CatoLynx/GIRA-Blinds-ESP8266-HW/BOM.xlsx

Item | Reference(s) | Order No. | Value | Supplier | Qty
1 | C1 | 593D226X9035D2TE3 | 22u | TME | 1
2 | C2 | VJ0603Y103KXAPW1BC | 10n | TME | 1
3 | C3,C7,C6 | CL21B105KOFNNNG | 1u | TME | 3
4 | C4 | 293D107X9010D2TE3 | 100u | TME | 1
5 | C5 | VJ0603Y104KXACW1BC | 100n | TME | 1
6 | D1 | SK110-DIO | SK110 | TME | 1
8 | L1 | B82432T1104K | 100u | TME | 1
9 | P1 |  | Interface | TME | 1
10 | Q1,Q2 | BC817-16-DIO | BC817 | TME | 2
11 | R5,R6,R1,R2 | RC0603FR-0710K | 10k | TME | 4
12 | R4,R3 | RC0603FR-074K7 | 4.7k | TME | 2
17 | U1 |  | ESP-12F | eBay | 1
18 | U2 | LM2674M-3.3/NOP | LM2674M-3.3 | TME | 1
