CatoLynx/GIRA-Blinds-ESP8266-HW/GIRA ESP8266 Jalousiesteuerung.kicad_pcb

## KiCad design GIRA ESP8266 Jalousiesteuerung.kicad_pcb (2018-10-30)

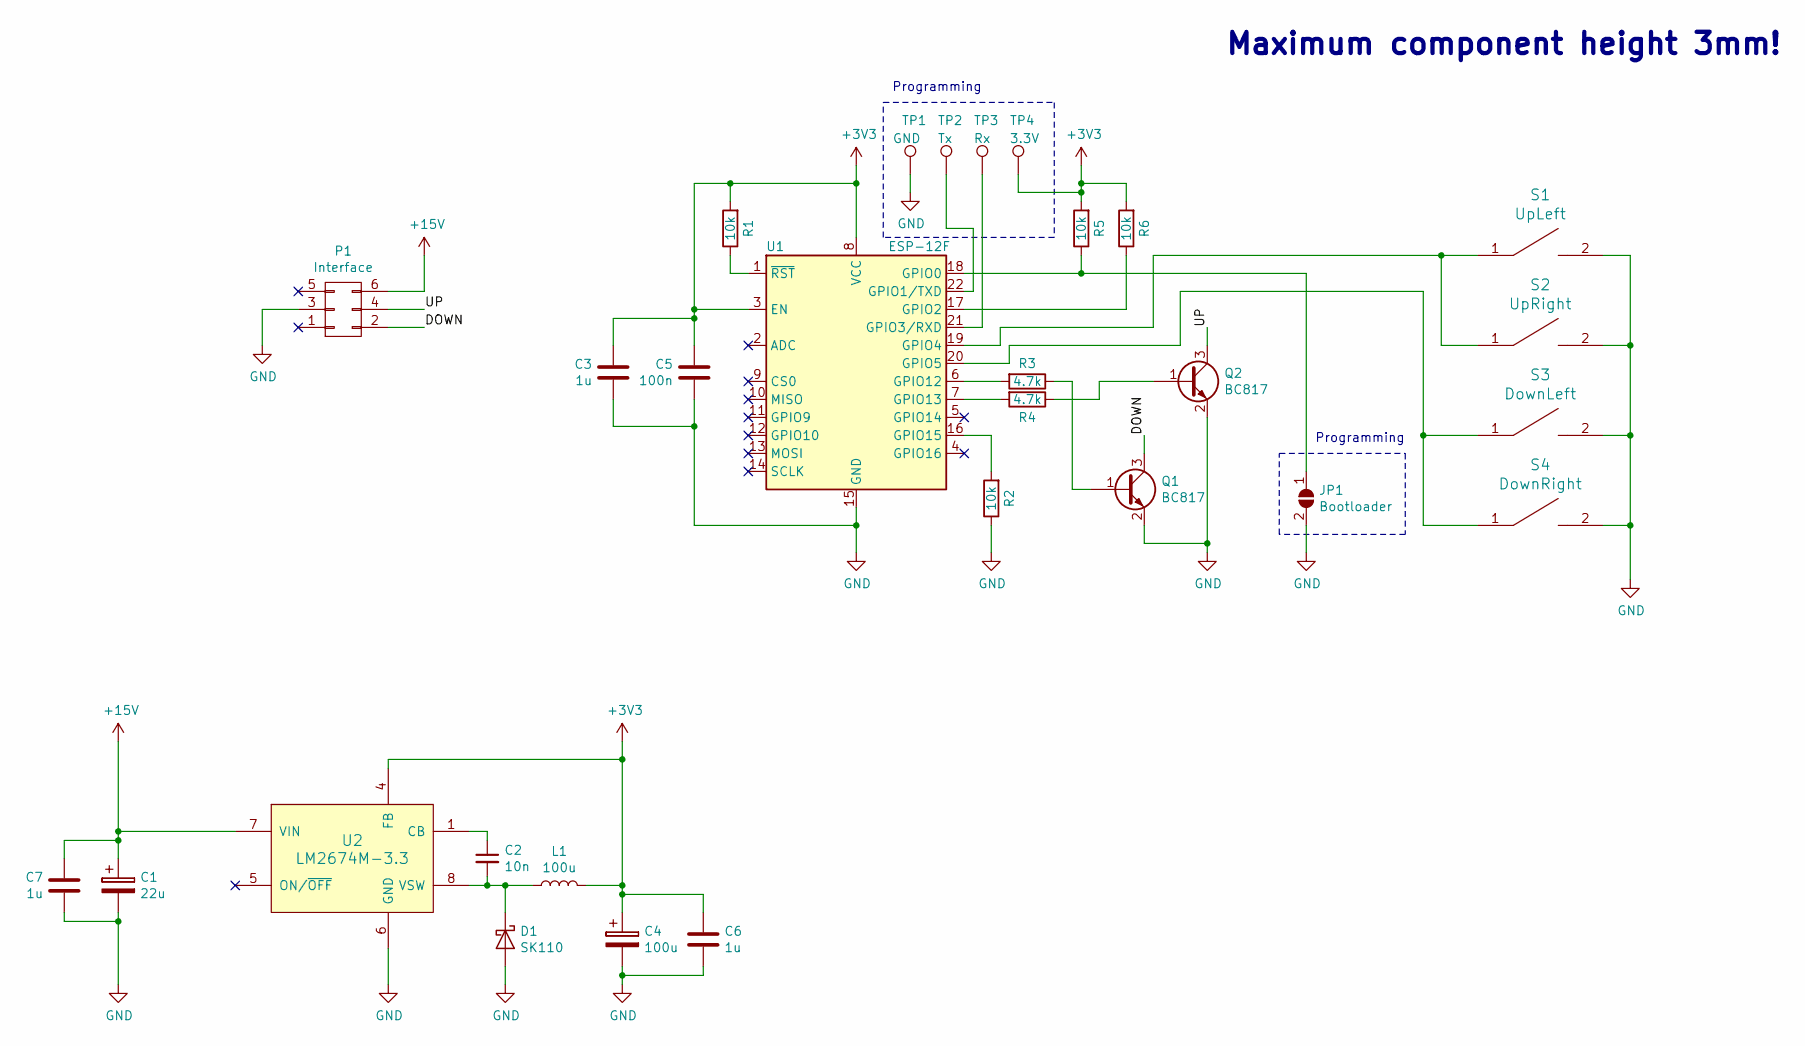
[picture p1: schematic GIRA ESP8266 Jalousiesteuerung.sch, GIRA ESP8266 Jalousiesteuerungs-Einsatz]

Parts:
C1: 22u; CP_Tantalum_Case-D_EIA-7343-31_Reflow
C2: 10n; C_0603
C3, C6, C7: 1u; C_0805
C4: 100u; CP_Tantalum_Case-D_EIA-7343-31_Reflow
C5: 100n; C_0603
D1: SK110; D_SMA_Standard
JP1: Bootloader; Jumper_SolderBridge
L1: 100u; L_1812
P1: Interface; Pin_Header_Straight_SMT_02x03
Q1, Q2: BC817; SOT-23
R1, R2, R5, R6: 10k; R_0603
R3, R4: 4.7k; R_0603
S1: UpLeft; Membrane_Switch_PCB_Only
S2: UpRight; Membrane_Switch_PCB_Only
S3: DownLeft; Membrane_Switch_PCB_Only
S4: DownRight; Membrane_Switch_PCB_Only
TP1: GND; Measurement_Point_Round-SMD-Pad_Small
TP2: Tx; Measurement_Point_Round-SMD-Pad_Small
TP3: Rx; Measurement_Point_Round-SMD-Pad_Small
TP4: 3.3V; Measurement_Point_Round-SMD-Pad_Small
U1: ESP-12F; ESP-12F_SMD
U2: LM2674M-3.3; SOIC-8_3.9x4.9mm_Pitch1.27mm

Connections:
+3V3: C3.2, C4.1, C5.2, C6.2, L1.2, R1.2, R5.2, R6.2, TP4.1, U1.3 (EN), U1.8 (VCC), U2.4 (FB)
+15V: C1.1, C7.2, P1.6, U2.7 (VIN)
/DOWN: P1.2, Q1.3 (C)
/UP: P1.4, Q2.3 (C)
GND: C1.2, C3.1, C4.2, C5.1, C6.1, C7.1, D1.2 (A), JP1.2 (B), P1.3, Q1.2 (E), Q2.2 (E), R2.1, S1.2, S2.2, S3.2, S4.2, TP1.1, U1.15 (GND), U2.6 (GND)
unnamed: C2.1, U2.1 (CB)
unnamed: C2.2, D1.1 (K), L1.1, U2.8 (VSW)
unnamed: JP1.1 (A), R5.1, U1.18 (GPIO0)
unnamed: Q1.1 (B), R3.1
unnamed: Q2.1 (B), R4.1
unnamed: R1.1, U1.1 (~RST)
unnamed: R2.2, U1.16 (GPIO15)
unnamed: R3.2, U1.6 (GPIO12)
unnamed: R4.2, U1.7 (GPIO13)
unnamed: R6.1, U1.17 (GPIO2)
unnamed: S1.1, S2.1, U1.19 (GPIO4)
unnamed: S3.1, S4.1, U1.20 (GPIO5)
unnamed: TP2.1, U1.22 (GPIO1/TXD)
unnamed: TP3.1, U1.21 (GPIO3/RXD)

Notes on the sheet:
Maximum component height 3mm!
Programming

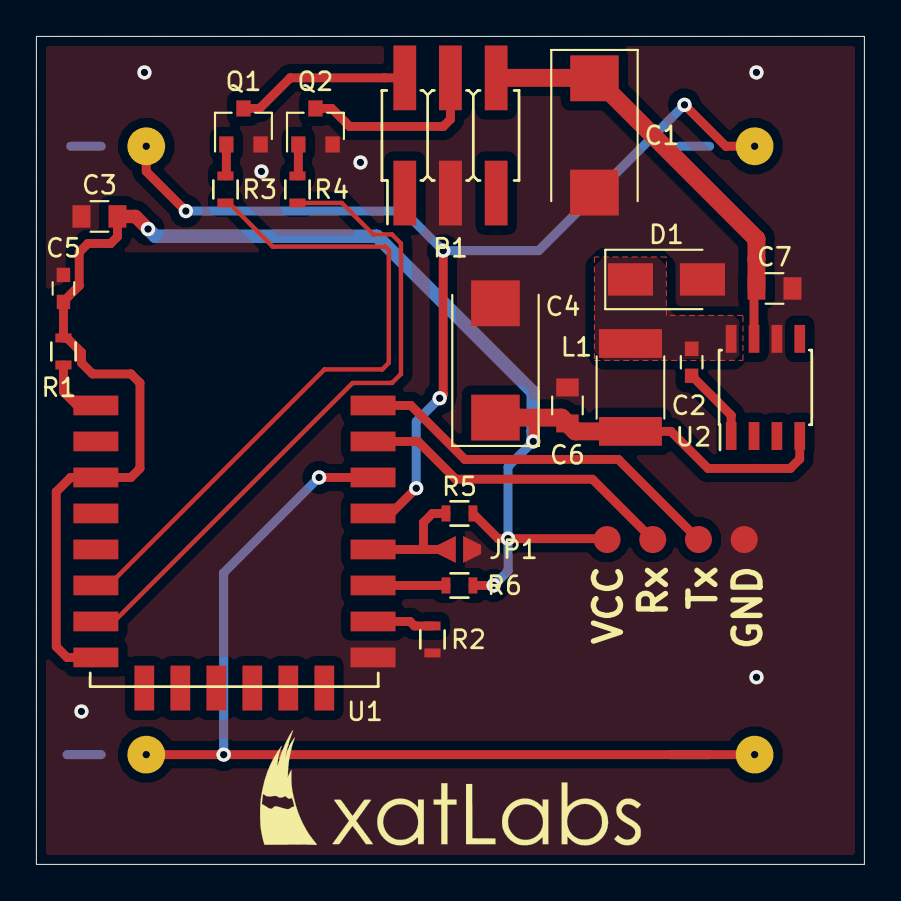
[picture p2: board GIRA ESP8266 Jalousiesteuerung.kicad_pcb from above]

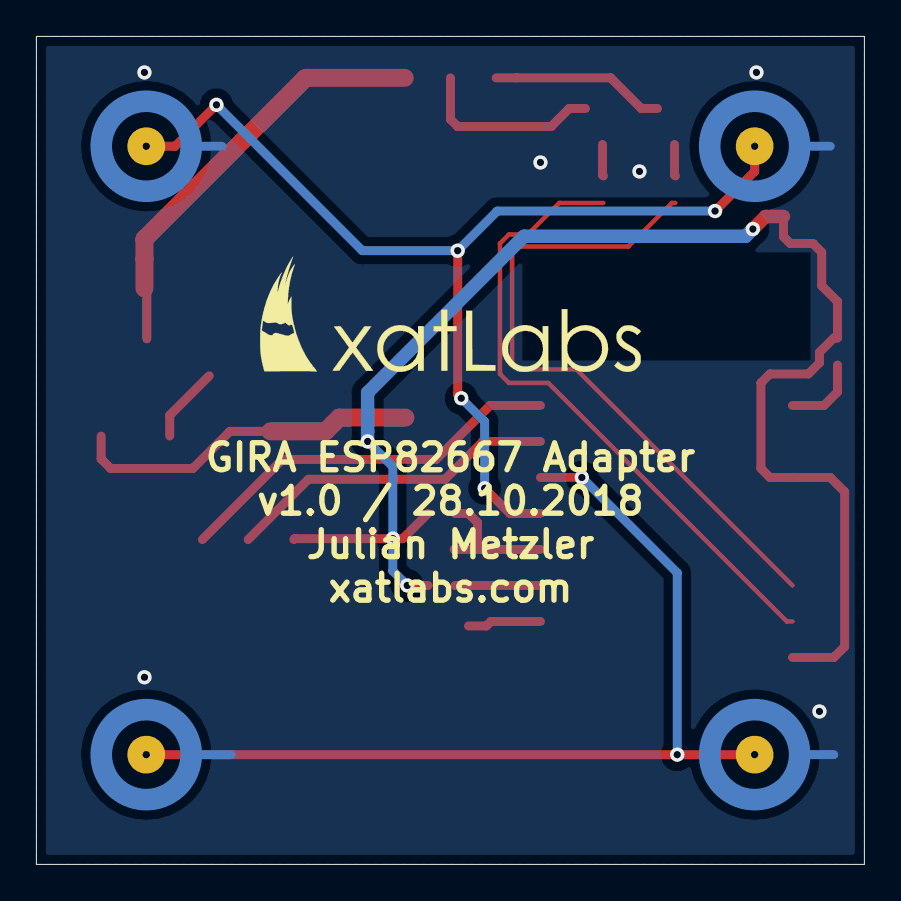
[picture p3: board GIRA ESP8266 Jalousiesteuerung.kicad_pcb from below]

Board: 2 copper layers, 46.0 x 46.0 mm, 29 parts (4 on the bottom side), 19 nets.
