CatoLynx/GIRA-Blinds-ESP8266-HW/(commit log)

2018-10-30 First version
    [GIRA ESP8266 Jalousiesteuerung-B.Cu.gbr, GIRA ESP8266 Jalousiesteuerung-B.Mask.gbr, GIRA ESP8266 Jalousiesteuerung-B.SilkS.gbr, GIRA ESP8266 Jalousiesteuerung-Edge.Cuts.gbr, GIRA ESP8266 Jalousiesteuerung-F.Cu.gbr, GIRA ESP8266 Jalousiesteuerung-F.Mask.gbr, GIRA ESP8266 Jalousiesteuerung-F.Paste.gbr, GIRA ESP8266 Jalousiesteuerung-F.SilkS.gbr]
2018-10-31 Added BOM
    [BOM.xlsx, GIRA ESP8266 Jalousiesteuerung.csv]
2020-09-29 Update BOM, add TODO
    [BOM.xlsx]
